Shaurya-Ashu/waken/IMG/IMG_3597.JPG

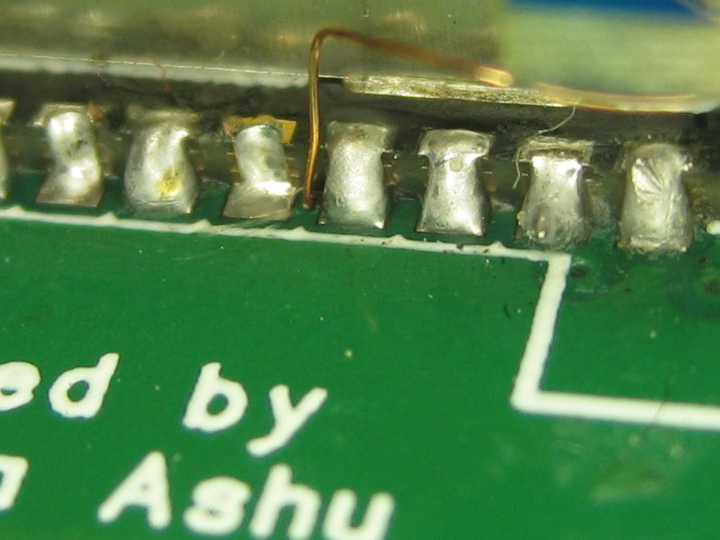
IMG/IMG_3597.JPG
