Shaurya-Ashu/waken/IMG/IMG_3583.JPG

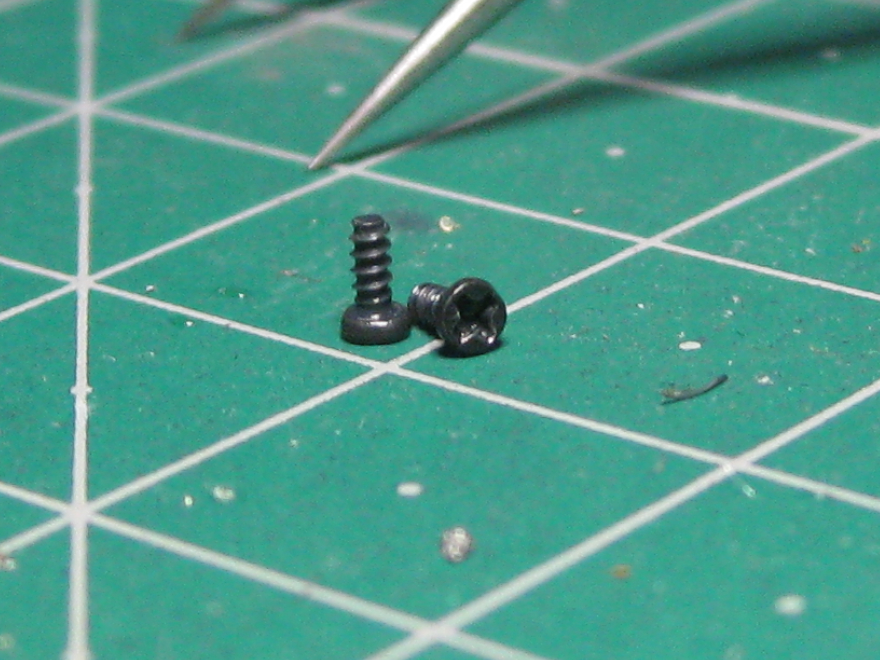
IMG/IMG_3583.JPG
