Shaurya-Ashu/waken/README.md

# waken
A ESP powered Smart watch which gives you a little zap to wake you up silently without disturbing anyone around you.

# why I built it ?
Ahhhh! I'm not crazy, I just sleep like a stone . So to get me up on time, I caught an idea why not make a watch which sits on my wrist and give me a little zap of 400V (\j) to wake me up . 

# Demo link
   https://youtu.be/53Z-3iZXITg?si=bSotyN73lvlZD2hz

# Zine

 Frame 7

 Frame 8

# prototype 01









WhatsApp Image 2026-08-12 at 00 28 32

WhatsApp Image 2026-08-12 at 00 47 58 (1)

# Shematics 
I've used EasyEDA for design designing this project

Screenshot 2026-07-18 at 12 30 59 AM

 It has ESP32S3-WROON-1-N16R8 as the main brains , it has been built RTC and feature both Wi-Fi and Bluetooth with access to multiple GPIOs .

 Screenshot 2026-07-19 at 11 32 55 PM

 For tracking motion and physical activities like step count, etc. I've used MPU6500 which features both I2C & SPI interface. I've used I2C interface for this project.
 
Screenshot 2026-07-19 at 11 33 51 PM

 For sensing temperature I used MCP9808 which also offers I2C interface so its easy to wire all of them in signle bus 

 Screenshot 2026-07-19 at 11 35 23 PM

 The heart rate sensor is MAX30101 with I2C interface which offers optical pulse oximetry and heart-rate sensing .

 Screenshot 2026-07-19 at 11 37 22 PM

 To charge the lipo battery i have integrated a charging ic for 1s lipo and also integrated a load sharing circuit so that i can use teh device while charging .

 Screenshot 2026-07-19 at 11 39 22 PM

 To provide a constant supply of 3.3 V I am integrated a buck boost converter output of 3.3V @1.5A 
 
 Screenshot 2026-07-19 at 11 41 27 PM

 Now for that little zap i have used a simple fly back circuit with a couple inductor of scale 1:100 and IRLR7843 N chaneel mosfet to turn it on and off and a some massive 400v rated caps to store the build up with a series resistance of 150K ohm for safety .
 
 Screenshot 2026-07-19 at 11 44 28 PM

For Inputs and outputs we have 2 push buttons and a side scroll wheel with oled and buzzers as our output 

Screenshot 2026-07-19 at 11 46 19 PM

# PCB 
 I have used 4 layer configuration

Top layer:- signals and some components

Screenshot 2026-07-18 at 7 22 29 PM

First inner layer:- ground

Screenshot 2026-07-18 at 7 22 35 PM

Second inner layer:- VCC

Screenshot 2026-07-18 at 7 22 40 PM

Bottom layer:- signal and all other components

Screenshot 2026-07-18 at 7 22 23 PM

Important Note : I have not connected the ground of flyback with the rest of the circuit I will use a physical wire to connect when I receive a PCB.

FRONT

BACK

# CAD 

I have used fusion 360 student edition for designing the 3D case for this watch

It is a very simple case on which the PCB is screwed using two screws, and the top part is tucked in and glued 


# Assembly

Top Case

The pcb is screwed in 

1 step

# Firmware 
 I stated a very brief sample test code till now. When I will receive my PCB, then I will work on the rest of the firmware.
