Shaurya-Ashu/waken/IMG/IMG_3579.JPG

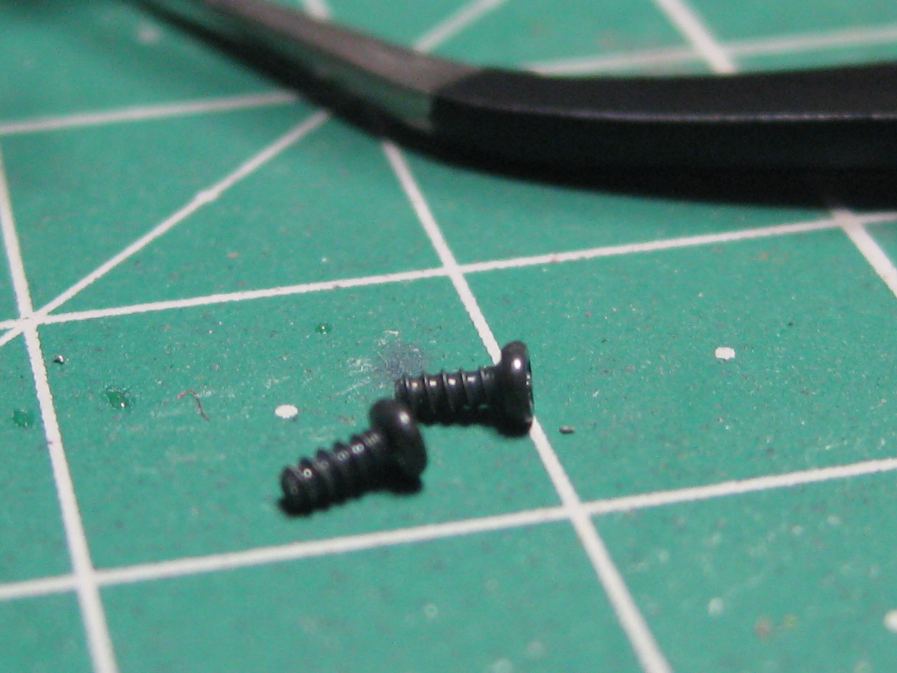
IMG/IMG_3579.JPG
