Shaurya-Ashu/waken/IMG/IMG_3580.JPG

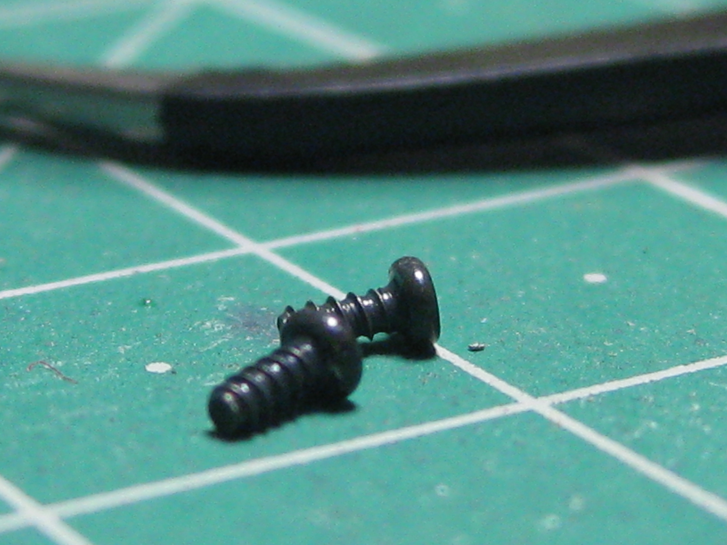
IMG/IMG_3580.JPG
