Shaurya-Ashu/waken/IMG/IMG_3581.JPG

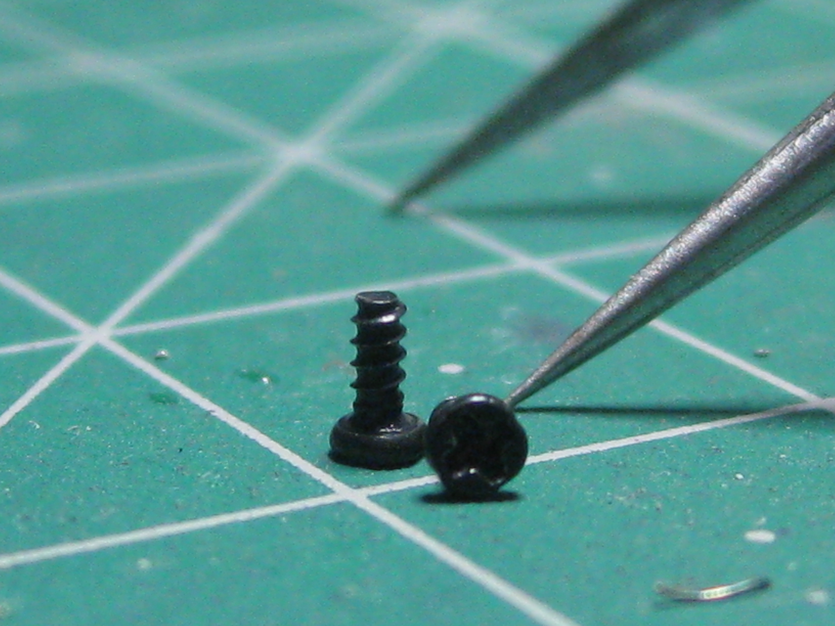
IMG/IMG_3581.JPG
