Shaurya-Ashu/waken/IMG/IMG_3582.JPG

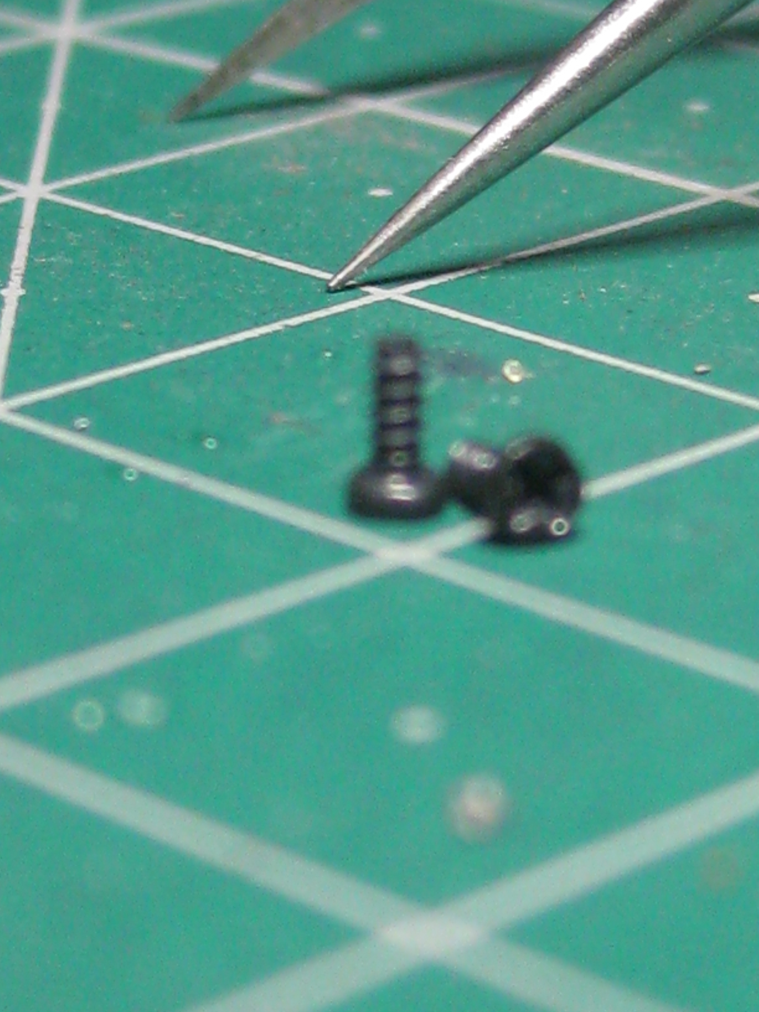
IMG/IMG_3582.JPG
