Shaurya-Ashu/waken/IMG/IMG_3584.JPG

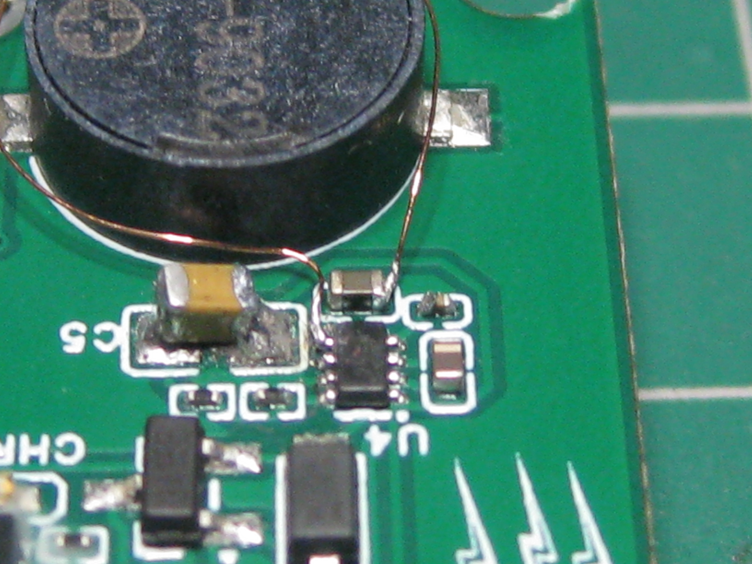
IMG/IMG_3584.JPG
