Shaurya-Ashu/waken/IMG/IMG_3585.JPG

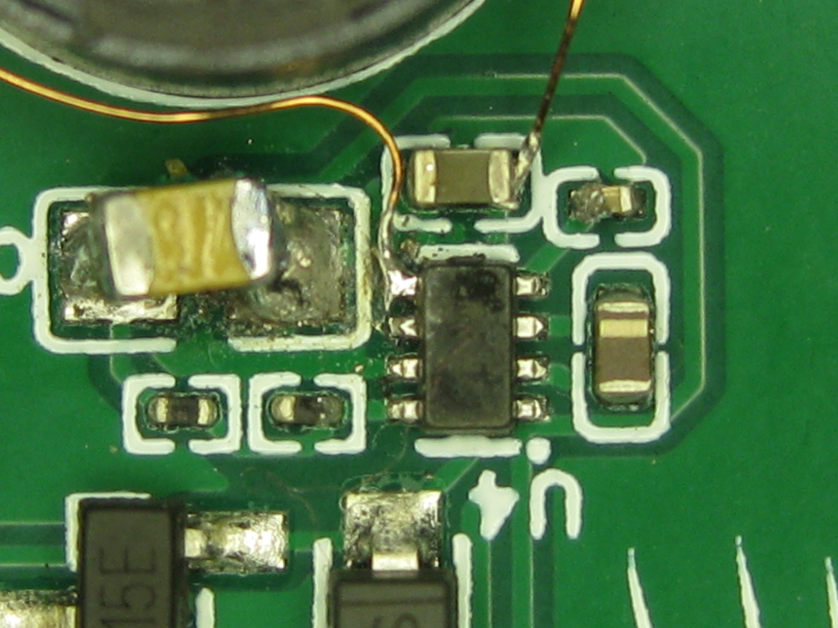
IMG/IMG_3585.JPG
