Shaurya-Ashu/waken/IMG/IMG_3586.JPG

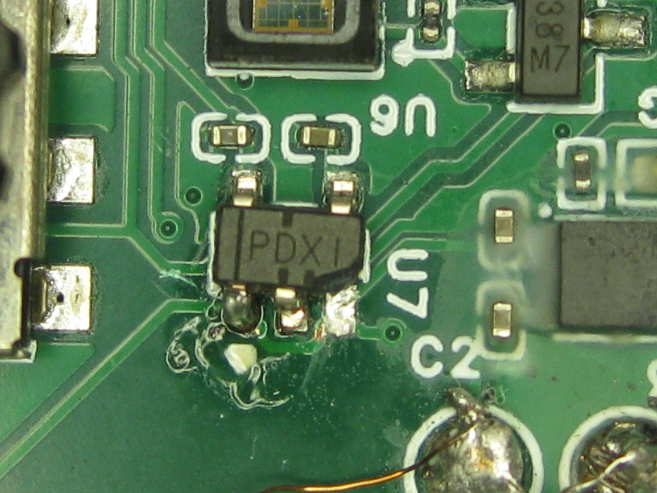
IMG/IMG_3586.JPG
