Shaurya-Ashu/waken/IMG/IMG_3587.JPG

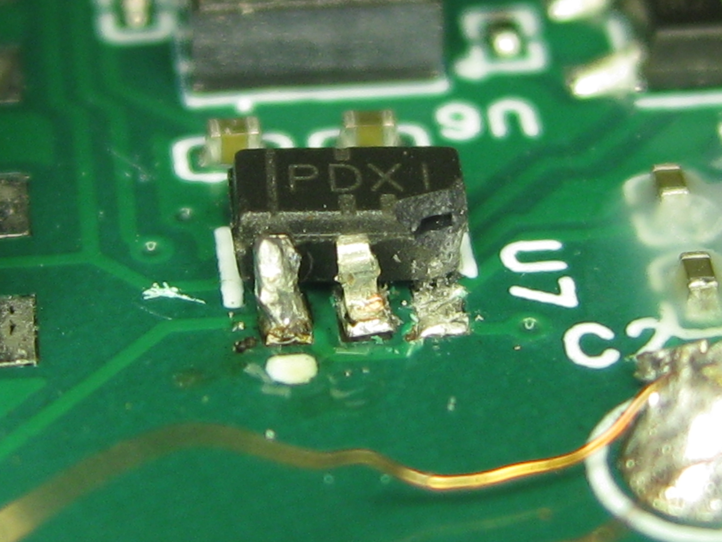
IMG/IMG_3587.JPG
