Shaurya-Ashu/waken/IMG/IMG_3588.JPG

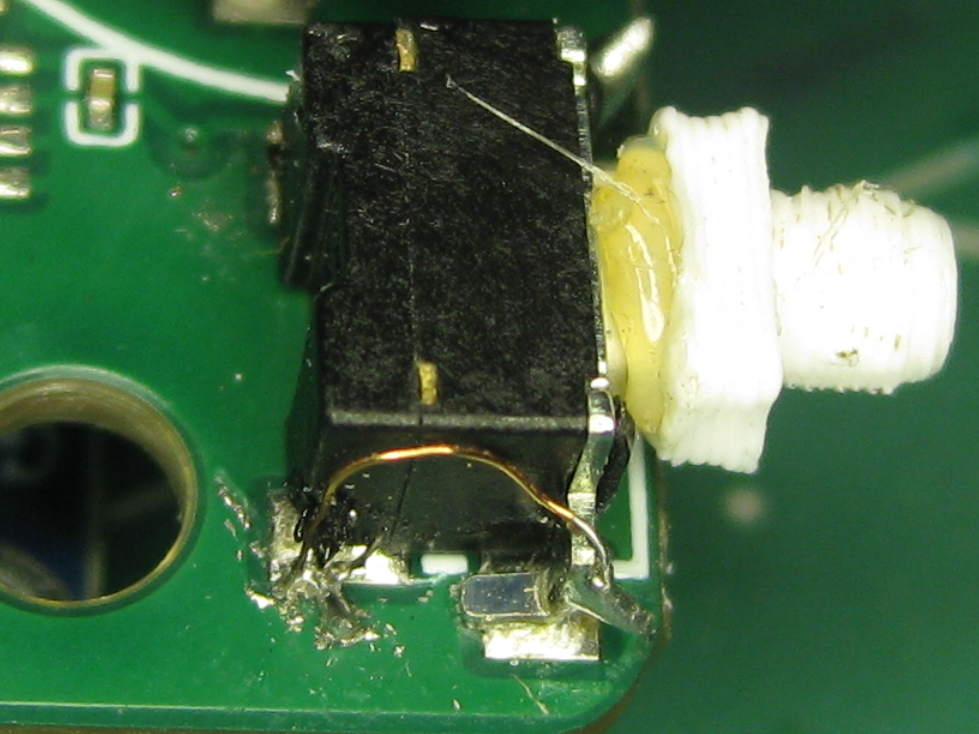
IMG/IMG_3588.JPG
