Shaurya-Ashu/waken/IMG/IMG_3589.JPG

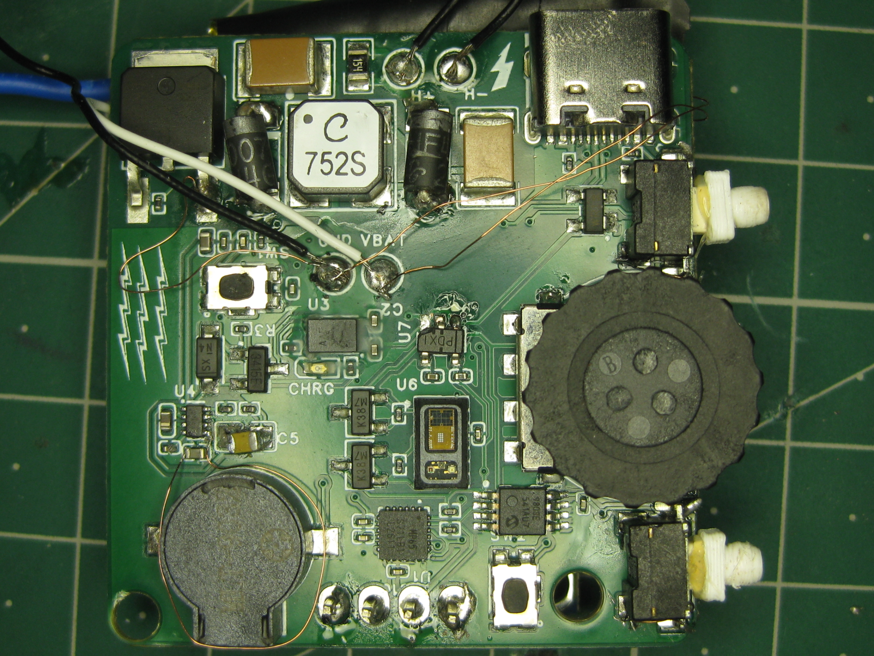
IMG/IMG_3589.JPG
