Shaurya-Ashu/waken/IMG/IMG_3590.JPG

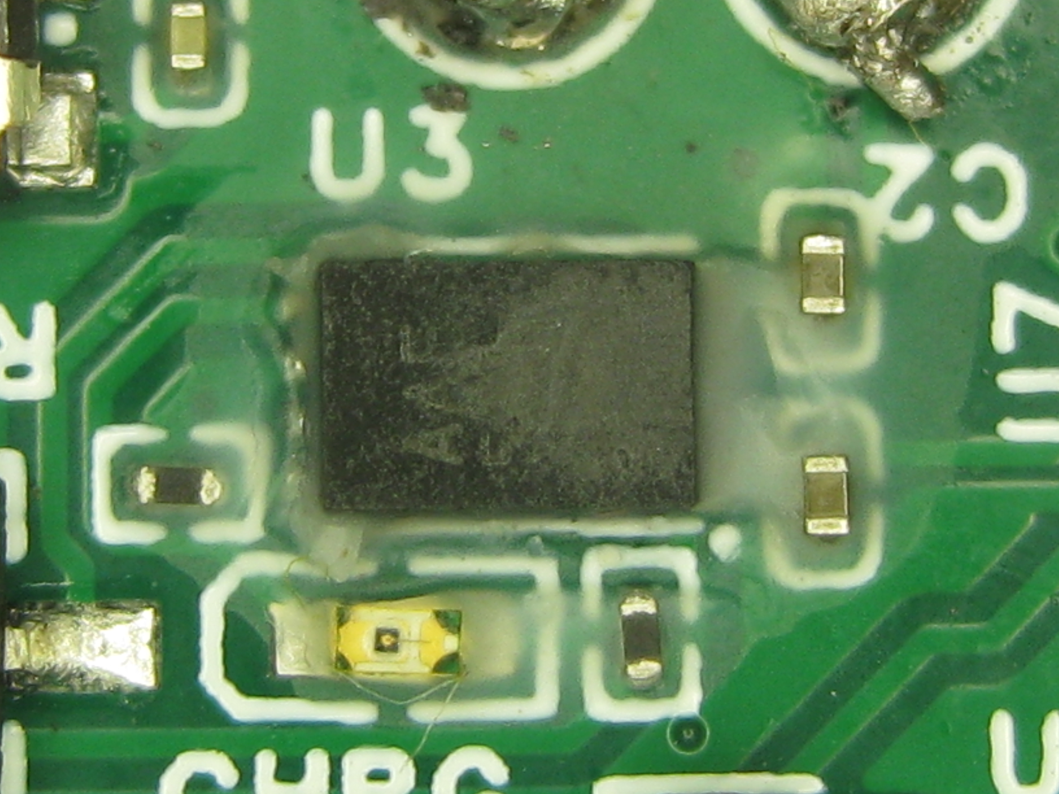
IMG/IMG_3590.JPG
