Shaurya-Ashu/waken/IMG/IMG_3591.JPG

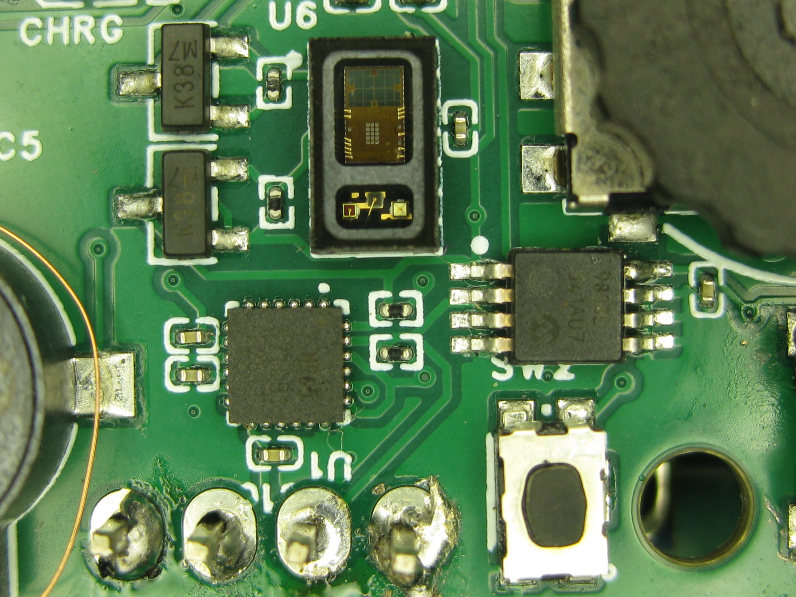
IMG/IMG_3591.JPG
