Shaurya-Ashu/waken/IMG/IMG_3592.JPG

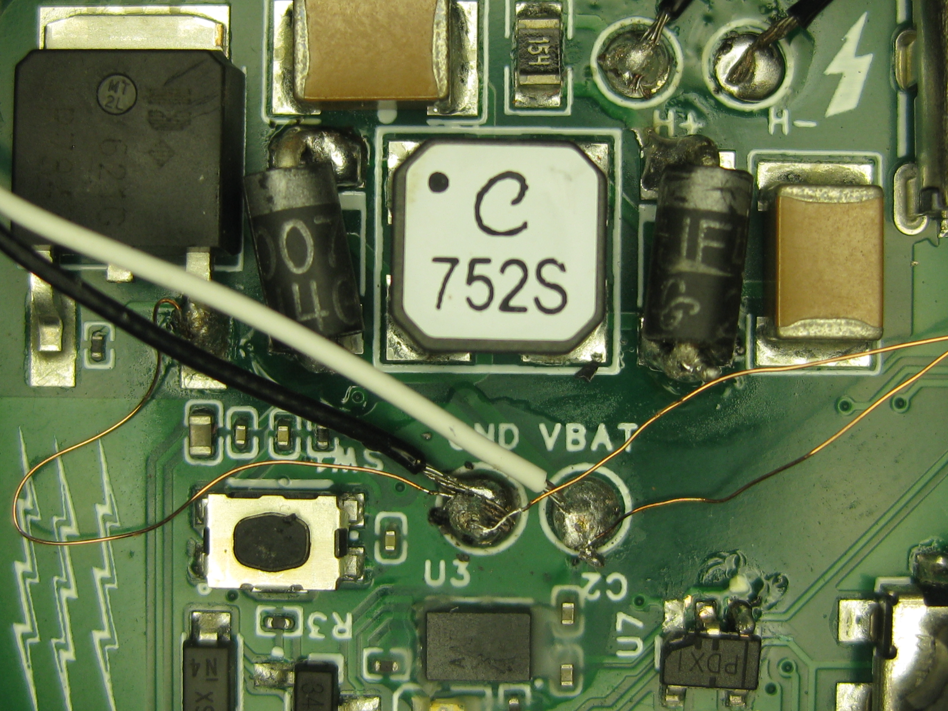
IMG/IMG_3592.JPG
