Shaurya-Ashu/waken/IMG/IMG_3593.JPG

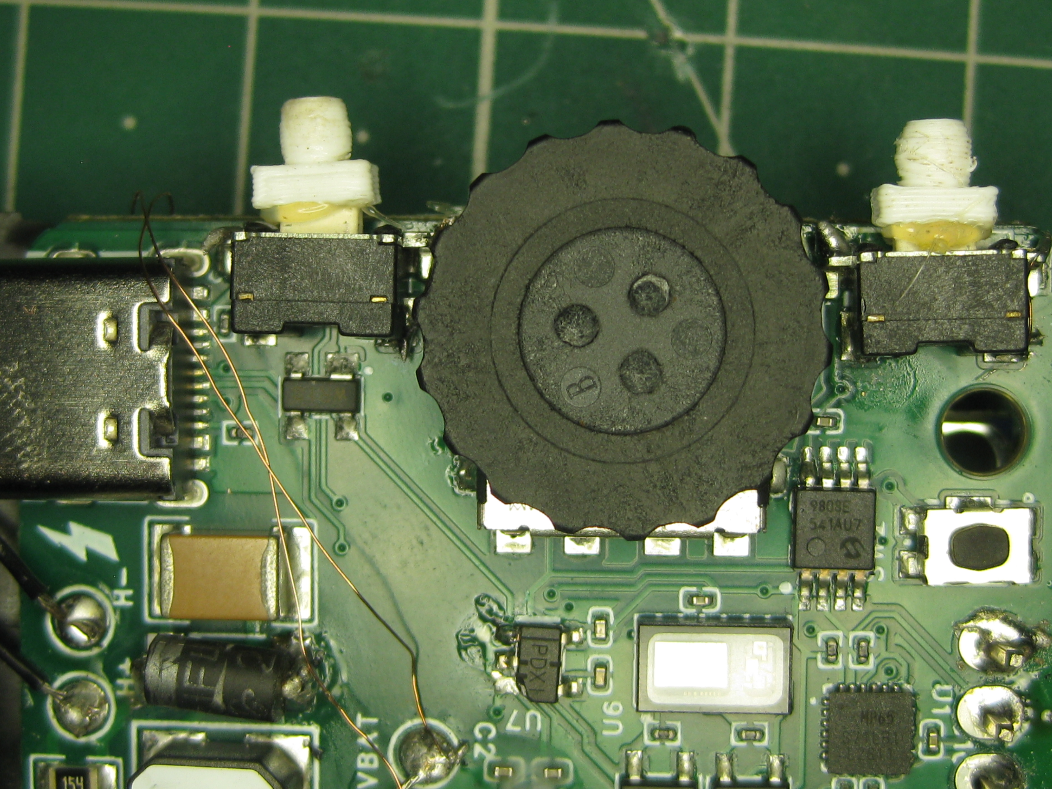
IMG/IMG_3593.JPG
