Shaurya-Ashu/waken/IMG/IMG_3594.JPG

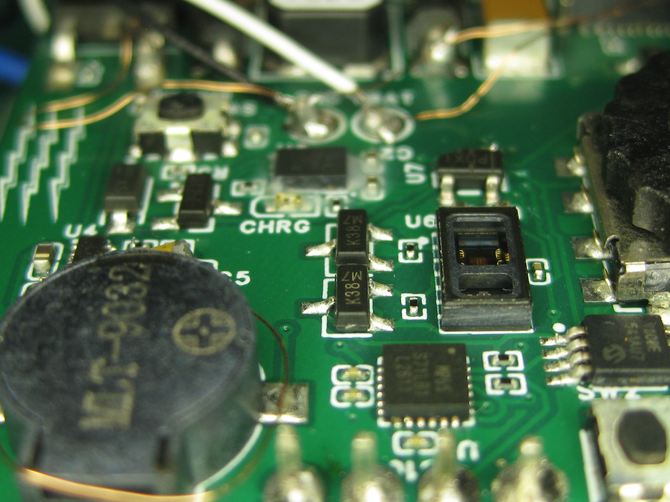
IMG/IMG_3594.JPG
