Shaurya-Ashu/waken/IMG/IMG_3595.JPG

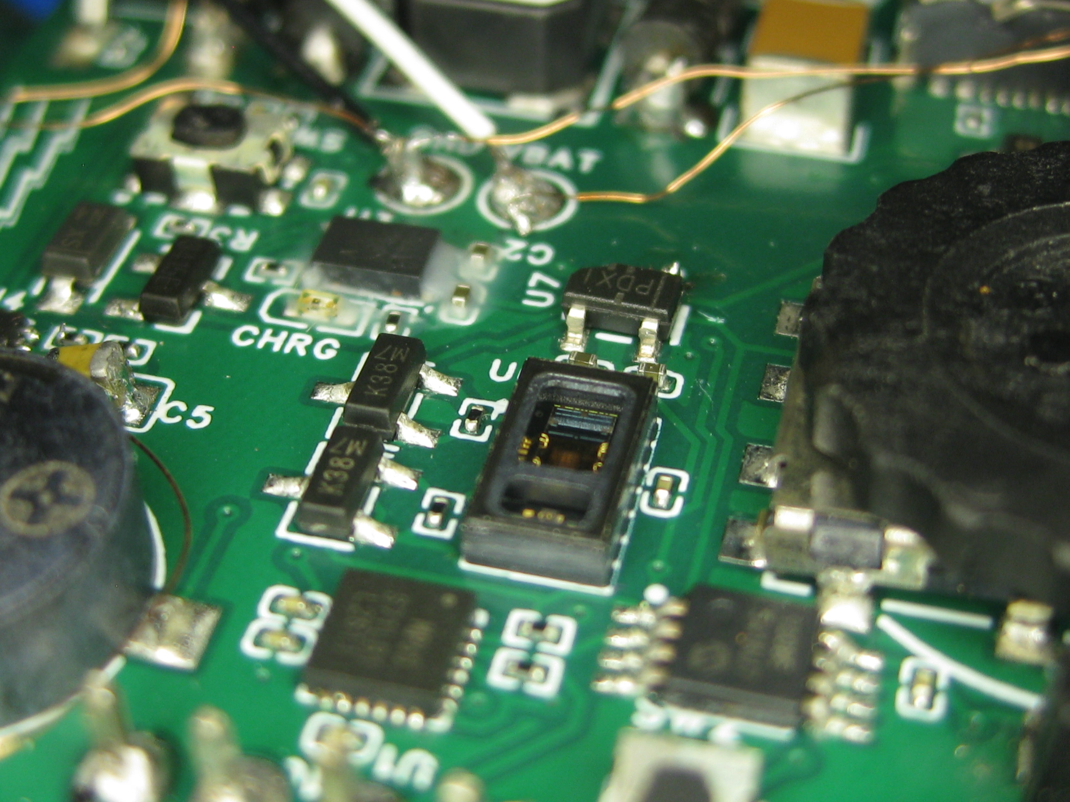
IMG/IMG_3595.JPG
