Shaurya-Ashu/waken/IMG/IMG_3596.JPG

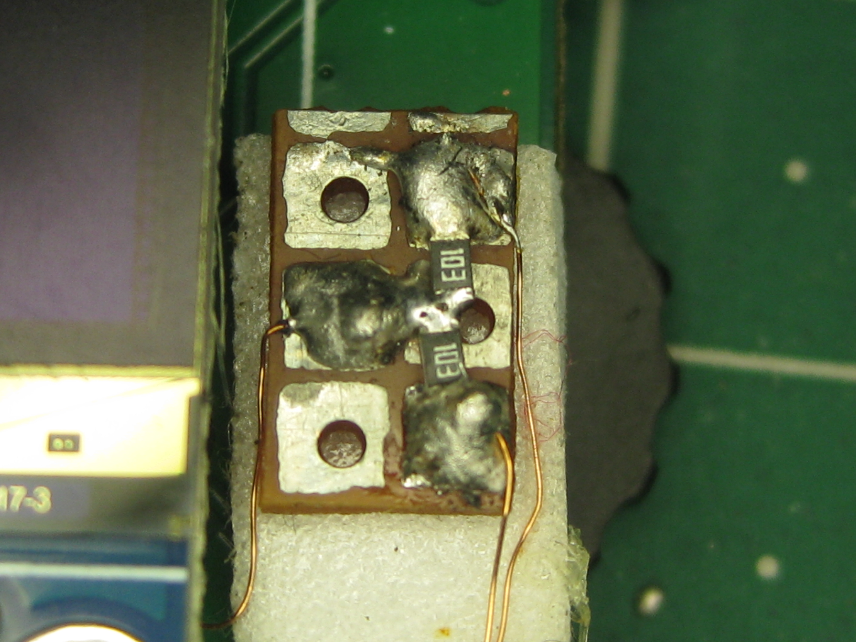
IMG/IMG_3596.JPG
