Shaurya-Ashu/waken/IMG/IMG_3598.JPG

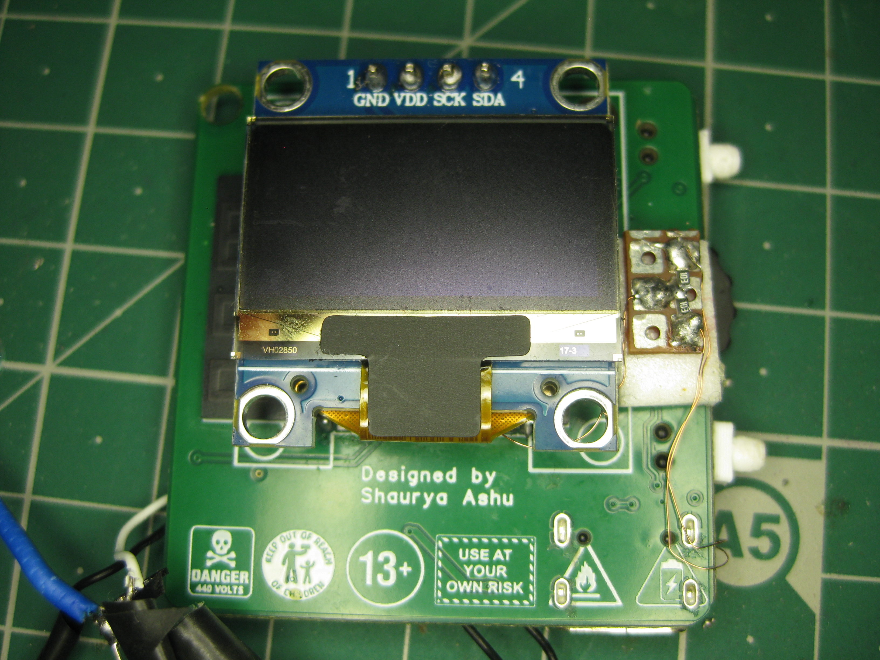
IMG/IMG_3598.JPG
