Shaurya-Ashu/waken/IMG/IMG_3599.JPG

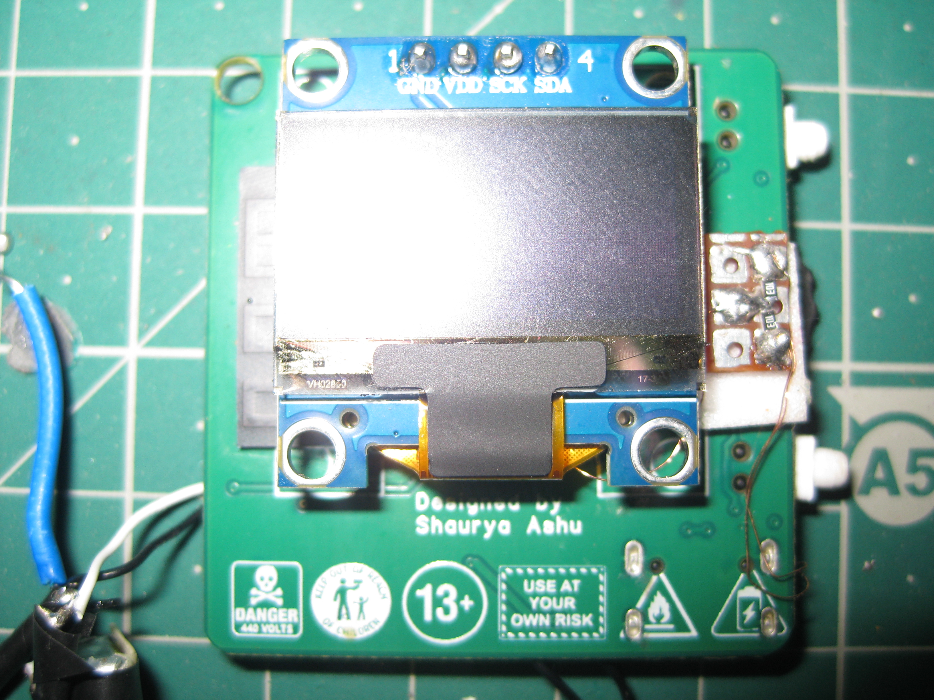
IMG/IMG_3599.JPG
