Shaurya-Ashu/waken/IMG/IMG_3600.JPG

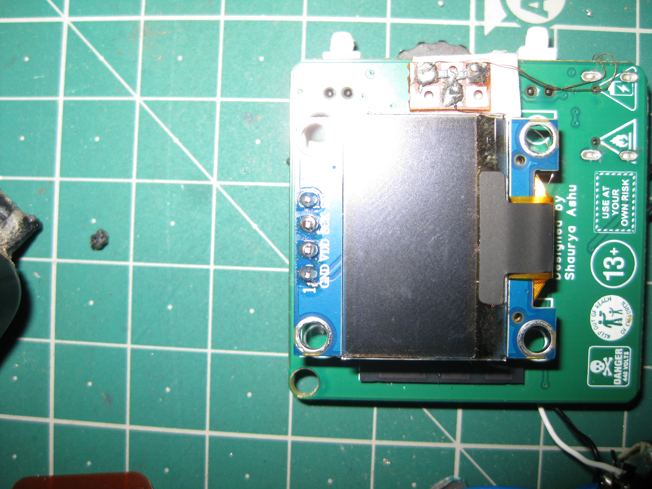
IMG/IMG_3600.JPG
