Shaurya-Ashu/waken/IMG/IMG_3601.JPG

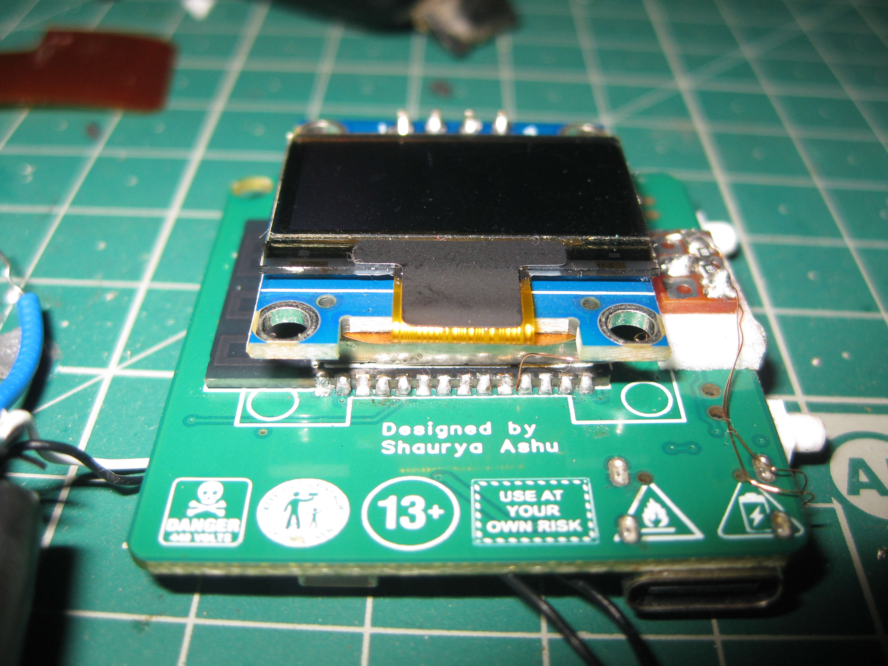
IMG/IMG_3601.JPG
