Shaurya-Ashu/waken/IMG/IMG_3602.JPG

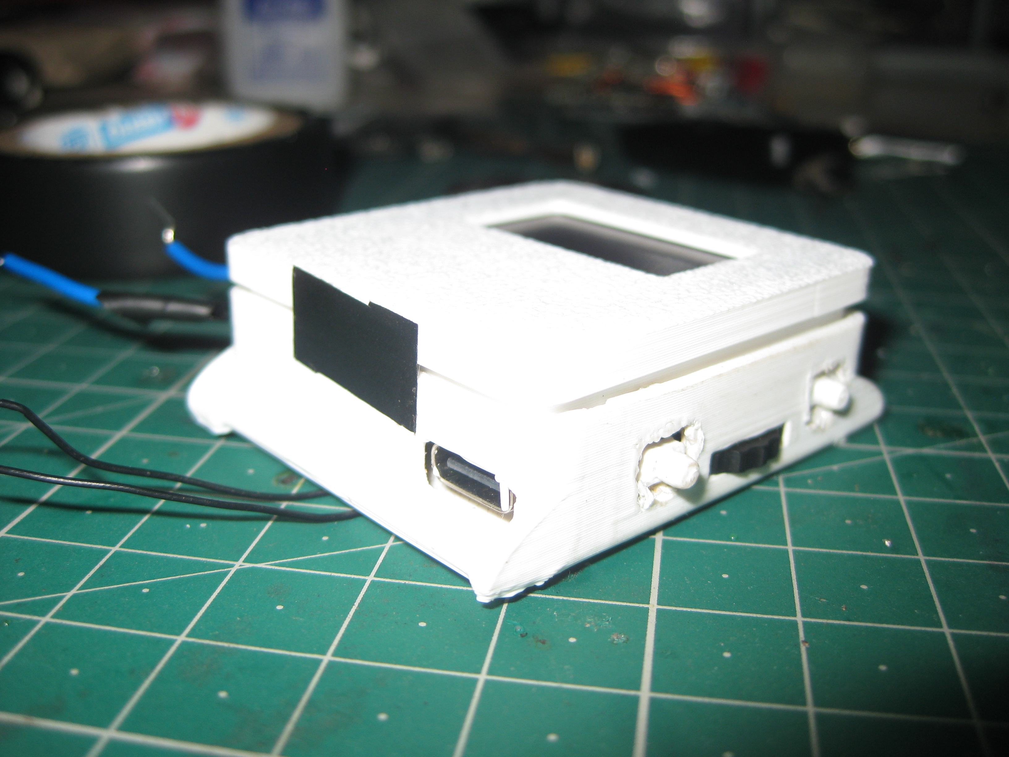
IMG/IMG_3602.JPG
