Shaurya-Ashu/waken/IMG/IMG_3603.JPG

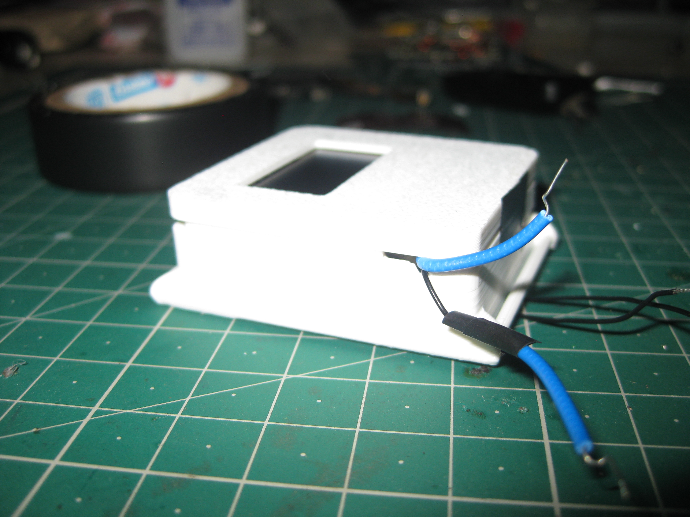
IMG/IMG_3603.JPG
