Shaurya-Ashu/waken/IMG/IMG_3604.JPG

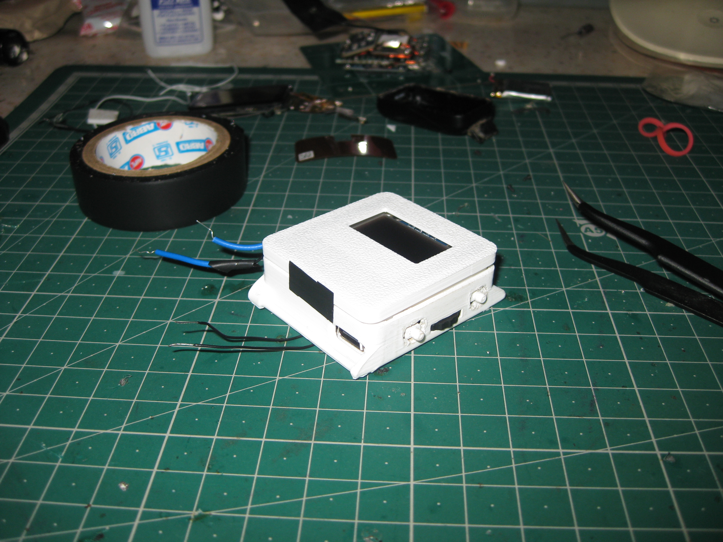
IMG/IMG_3604.JPG
