Shaurya-Ashu/waken/IMG/IMG_3605.JPG

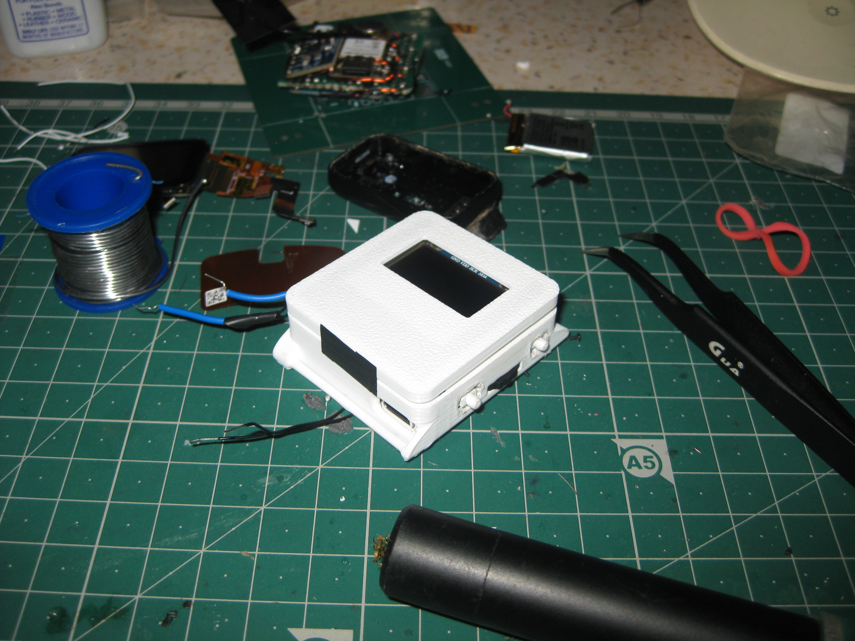
IMG/IMG_3605.JPG
