Shaurya-Ashu/waken/IMG/IMG_3606.JPG

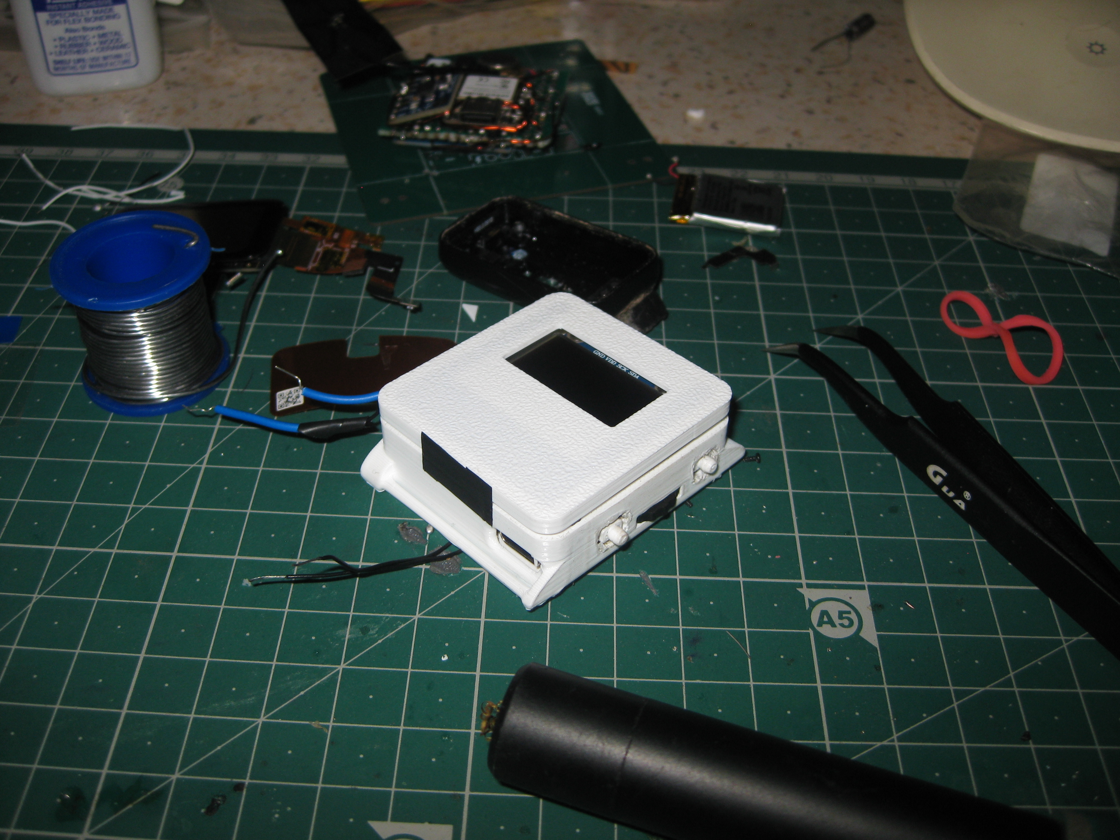
IMG/IMG_3606.JPG
