Shaurya-Ashu/waken/IMG/IMG_3607.JPG

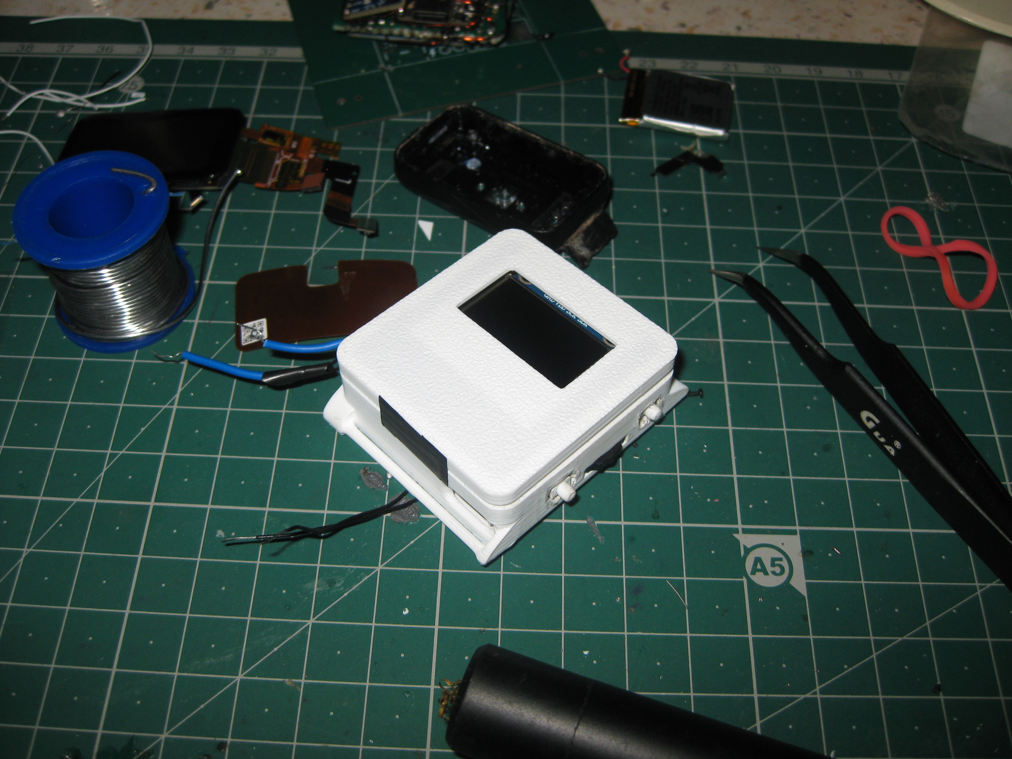
IMG/IMG_3607.JPG
