Shaurya-Ashu/waken/IMG/IMG_3608.JPG

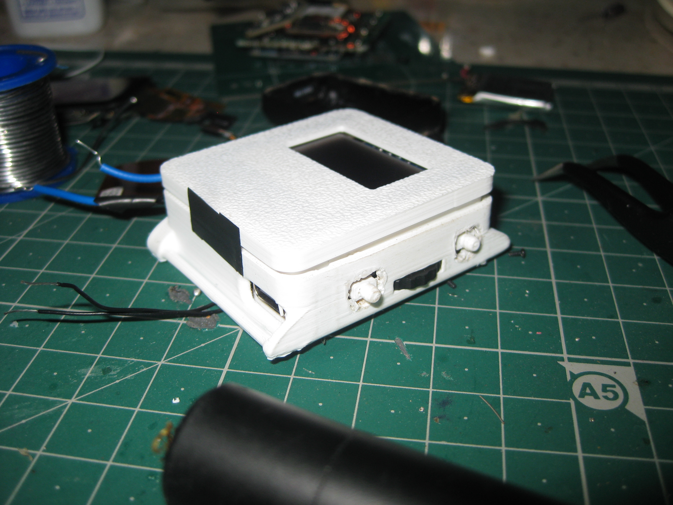
IMG/IMG_3608.JPG
