Shaurya-Ashu/waken/Production/waken.csv

No. | Quantity | Comment | Designator | Footprint | Value | Manufacturer Part | Manufacturer | Supplier Part | Supplier | LCSC Price | JLCPCB Price
1 | 2 | KMR223GLFG | BOOT,RST | SW-SMD_5P-L4.2-W2.8-P1.60-LS4.6-TR |  | KMR223GLFG | C&K | C221678 | LCSC |  | 0.1568
2 | 1 | 2.4GHz | BRAINS | WIRELM-SMD_ESP32-S3-WROOM-1 | 2.4GHz | ESP32-S3-WROOM-1-N16R8 | ESPRESSIF(乐鑫) | C2913202 | LCSC |  | 0.7623
3 | 1 | MLT-9032 | BUZZER1 | BUZ-SMD_MLT-9032 |  | MLT-9032 | 华能 | C194480 | LCSC |  | 0.0484
4 | 4 | 4.7uF | C1,C2,C13,C14 | C0201 | 4.7uF | JDK063BBJ475MV-AT | TAIYO YUDEN(太诱) | C2880368 | LCSC |  | 0.0085
5 | 1 | 1uF | C3 | C0201 | 1uF | CL03A105MQ3CSNH | SAMSUNG(三星) | C53067 | LCSC |  | 0.001
6 | 2 | 22uF | C4,C6 | C0402 | 22uF | JDK105CBJ226MV-F | TAIYO YUDEN(太诱) | C385994 | LCSC |  | 0.0246
7 | 1 | 47uF | C5 | C0805 | 47uF | GRM21BR60J476ME15L | muRata(村田) | C77072 | LCSC |  | 0.0407
8 | 1 | 1uF | C7 | C0201 | 1uF | GRM033R60J105KEA2D | muRata(村田) | C76929 | LCSC |  | 0.0022
9 | 7 | 100nF | C8,C9,C10,C11,C12,C15,C16 | C0201 | 100nF | GRM033R60J104KE19D | muRata(村田) | C76928 | LCSC |  | 0.0005
10 | 2 | 470nF | C17,C18 | C1812 | 470nF | C4532X7T2W474KT000N | TDK | C342626 | LCSC |  | 0.0987
11 | 1 | 16-213SDRC/S530-A3/TR8 | CHRG | LED0402-R-RD |  | 16-213SDRC/S530-A3/TR8 | EVERLIGHT(亿光) | C71911 | LCSC |  | 0.0049
12 | 1 | B130LAW-7-F | D1 | SOD-123_L2.8-W1.8-LS3.7-RD |  | B130LAW-7-F | DIODES(美台) | C129191 | LCSC |  | 0.05
13 | 1 | PRTR5V0U2X | D2 | SOT-143-4_L2.9-W1.3-P1.92-LS2.4-BL |  | PRTR5V0U2X | TECH PUBLIC(台舟) | C2827688 | LCSC |  | 0.0099
14 | 2 | SUF4007 | D3,D4 | DO-213AB_L5.0-W2.5-RD |  | SUF4007 | DIOTEC(德欧泰克) | C212757 | LCSC |  | 0.0149
15 | 4 | YTC1P-3515-01 | H+,H-,U10,VBAT | TESTPOINT-SMD_BD2.0_C9900030651 |  | YTC1P-3515-01 | YIYUAN(怡远) | C5221292 | LCSC |  | 0.0235
16 | 1 | 1uH | L1 | L0402 | 1uH | LSCNB1005EET1R0MB | TAIYO YUDEN(太诱) | C6653407 | LCSC |  | 0.0541
17 | 1 | LPR6235-752SMRC | L2 | IND-SMD_4P-L6.0-W6.0_LPR6235-752SMRC |  | LPR6235-752SMRC | Coilcraft(线艺) | C7501749 | LCSC |  | 1.1268
18 | 1 | OLED DISPLAY 128X64 | OLED1 | 0.96-OLED-DISPLAY
19 | 1 | DMP1045U-HXY | Q1 | SOT-23-3_L2.9-W1.5-P1.90-LS2.6-BR |  | DMP1045U-HXY | HXY MOSFET(华轩阳电子) | C22366440 | LCSC |  | 0.0109
20 | 2 | BSS138-7-F | Q2,Q3 | SOT-23-3_L2.9-W1.6-P1.90-LS2.8-BR |  | BSS138-7-F | DIODES(美台) | C40912 | LCSC |  | 0.0074
21 | 1 | IRLR7843-DO | Q4 | TO-252-2_L6.6-W6.2-P4.57-LS10.1-BR-CW |  | IRLR7843-DO | DOINGTER(杜因特) | C49208603 | LCSC |  | 0.0312
22 | 1 | 470Ω | R1 | R0201 | 470Ω | RTT014700FTH | RALEC(旺诠) | C166182 | LCSC |  | 0.0003
23 | 3 | 10kΩ | R2,R11,R16 | R0201 | 10kΩ | RTT011002FTH | RALEC(旺诠) | C102684 | LCSC |  | 0.0002
24 | 1 | 100kΩ | R3 | R0201 | 100kΩ | CR0201FH1003G | LIZ(丽智电子) | C100127 | LCSC |  | 0.0007
25 | 2 | 5.1kΩ | R4,R5 | R0201 | 5.1kΩ | RC0201JR-075K1L | YAGEO(国巨) | C163490 | LCSC |  | 0.0003
26 | 1 | 511kΩ | R6 | R0201 | 511kΩ | 0201WMF5113TEE | UNI-ROYAL(厚声) | C270342 | LCSC |  | 0.0002
27 | 1 | 91kΩ | R7 | R0201 | 91kΩ | RTT01913JTH | RALEC(旺诠) | C158299 | LCSC |  | 0.0002
28 | 2 | 10kΩ | R8,R15 | R0201 | 10kΩ | RTT01103JTH | RALEC(旺诠) | C102690 | LCSC |  | 0.0003
29 | 4 | 4.7kΩ | R9,R10,R13,R14 | R0201 | 4.7kΩ | RC0201JR-074K7L | YAGEO(国巨) | C142008 | LCSC |  | 0.0004
30 | 1 | 150kΩ | R12 | R0805 | 150kΩ | 0805W8J0154T5E | UNI-ROYAL(厚声) | C25619 | LCSC |  | 0.0006
31 | 2 | K2-1845SA-D4SW-04 | SW3,SW4 | KEY-SMD_K2-1845SA-D4SW-04 |  | K2-1845SA-D4SW-04 | 韩国韩荣 | C128934 | LCSC |  | 0.0155
32 | 1 | MPU-6500 | U1 | QFN-24_L3.0-W3.0-P0.40-BL-EP |  | MPU-6500 | TDK InvenSense(应美盛) | C50278 | LCSC |  | 0.7847
33 | 1 | MCP73831T-2ACI/MC | U3 | DFN-8_L3.0-W2.0-P0.50-BL-EP1.6 |  | MCP73831T-2ACI/MC | MICROCHIP(美国微芯) | C411870 | LCSC |  | 0.1499
34 | 1 | TPS631000DRLR | U4 | SOT-583-8_L2.1-W1.2-P0.50-LS1.6-BL |  | TPS631000DRLR | TI(德州仪器) | C5219190 | LCSC |  | 0.0823
35 | 1 | MCP9808-E/MS | U5 | MSOP-8_L3.0-W3.0-P0.65-LS4.9-BL |  | MCP9808-E/MS | MICROCHIP(美国微芯) | C94847 | LCSC |  | 0.3288
36 | 1 | MAX30101EFD+T | U6 | OESIP-14_L5.6-W3.3-P0.80-TL |  | MAX30101EFD+T | ADI(亚德诺)/MAXIM(美信) | C2859066 | LCSC |  | 1.567
37 | 1 | TPS78918DBVR | U7 | SOT-23-5_L2.9-W1.6-P0.95-LS2.8-BR |  | TPS78918DBVR | TI(德州仪器) | C2873122 | LCSC |  | 0.2536
38 | 1 | SIQ-02FVS3 | U8 | SW-SMD_SIQ-02FVS3_1 |  | SIQ-02FVS3 | MITSUMI(美上美) | C2925423 | LCSC |  | 0.6386
39 | 1 | USB-310-B-SU | USB | USB-C-SMD_20P-P0.50-L7.4-W8.9 |  | USB-310-B-SU | HOOYA(皓宇电子) | C309347 | LCSC |  | 0.0331
