Shaurya-Ashu/waken/PCB/waken.pdf

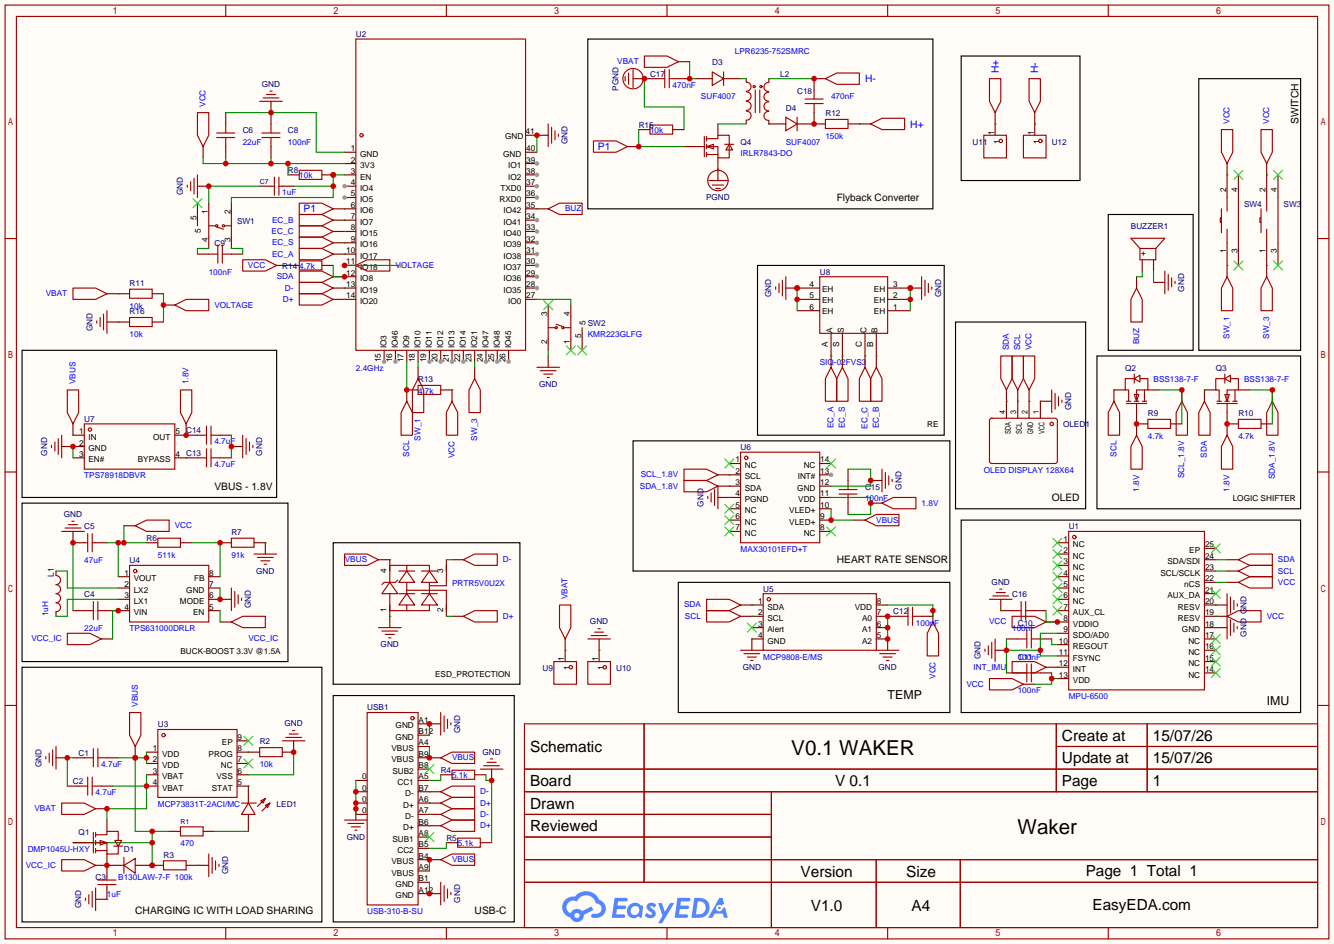
[picture p31: page 1]

VLED+ 10 VDD 11 GND 12 INT# 13 NC 14

Schematic | V0.1 WAKER | Create at | 15/07/26

Update at | 15/07/26

Board | V 0.1 | Page | 1
Drawn | | Waker
Reviewed

Version | Size | Page 1 Total 1
V1.0 | A4 | EasyEDA.com
