Shaurya-Ashu/waken/ZINE/Frame 8.pdf

# WAKEN

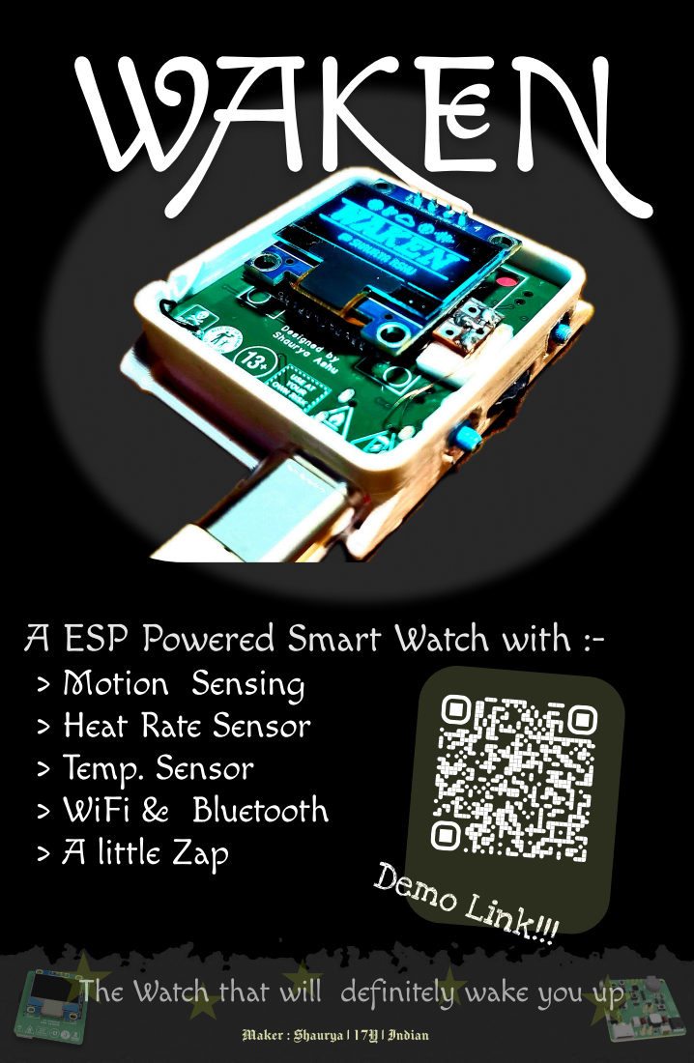
[picture p32: page 1]
> A little Zap; Demo Link!!!

A ESP Powered Smart Watch with :-
> Motion Sensing
> Heat Rate Sensor
> Temp. Sensor
> WiFi & Bluetooth

The Watch that will definitely wake you up

Maker : Shaurya | 17Y | Indian
