Shaurya-Ashu/waken/(commit log)

2026-08-11 Update README with demo link and prototype info
    Added demo link and prototype section to README.
2026-08-12 uptaded pcb
    [waken.csv, waken.xlsx]
